yonaguska/SMD_test_rig_with_Pico/Photos/2026-06-17_19-35-20_testing.png

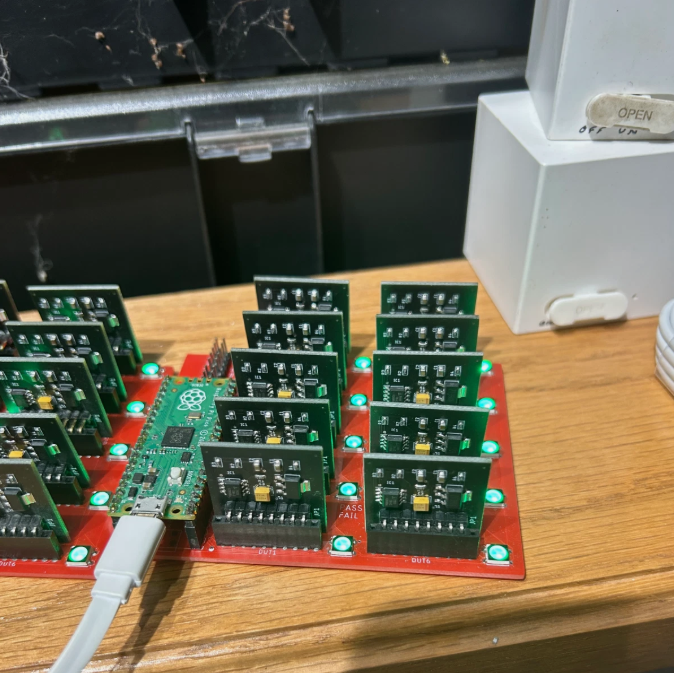
Photos/2026-06-17_19-35-20_testing.png
