yonaguska/SMD_test_rig_with_Pico/README.md

# SMD_test_rig_with_Pico
This is an automated test system for the SMD watchdog timers.
