yonaguska/SMD_test_rig_with_Pico/Photos/image0.jpeg

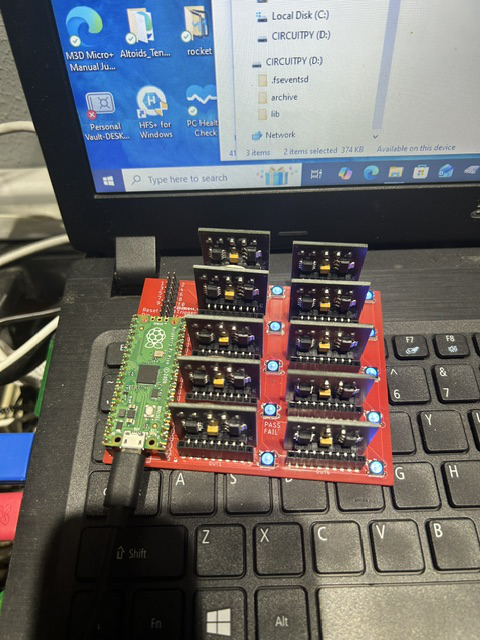
Photos/image0.jpeg
