yonaguska/SMD_test_rig_with_Pico/Photos/image1.jpeg

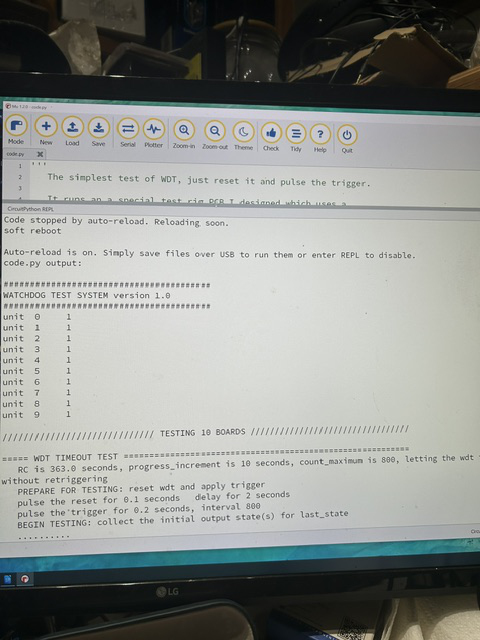
Photos/image1.jpeg
