yonaguska/SMD_test_rig_with_Pico/Photos/IMG_9965.jpeg

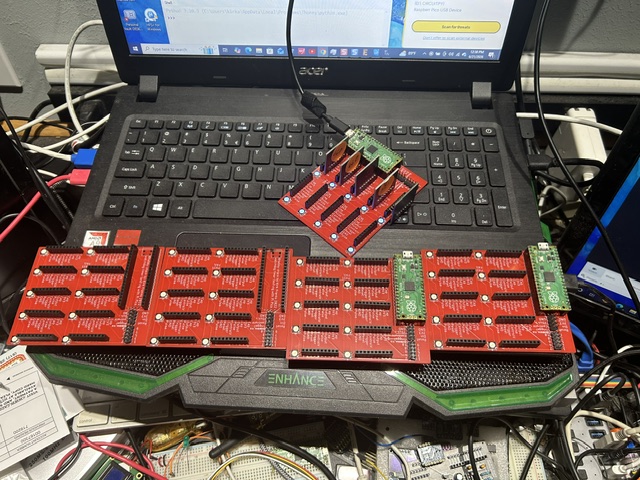
Photos/IMG_9965.jpeg
