yonaguska/SMD_test_rig_with_Pico/Eagle/smd_test_rig_with_pico.brd

## EAGLE design Eagle/smd_test_rig_with_pico.brd (2026-06-21)

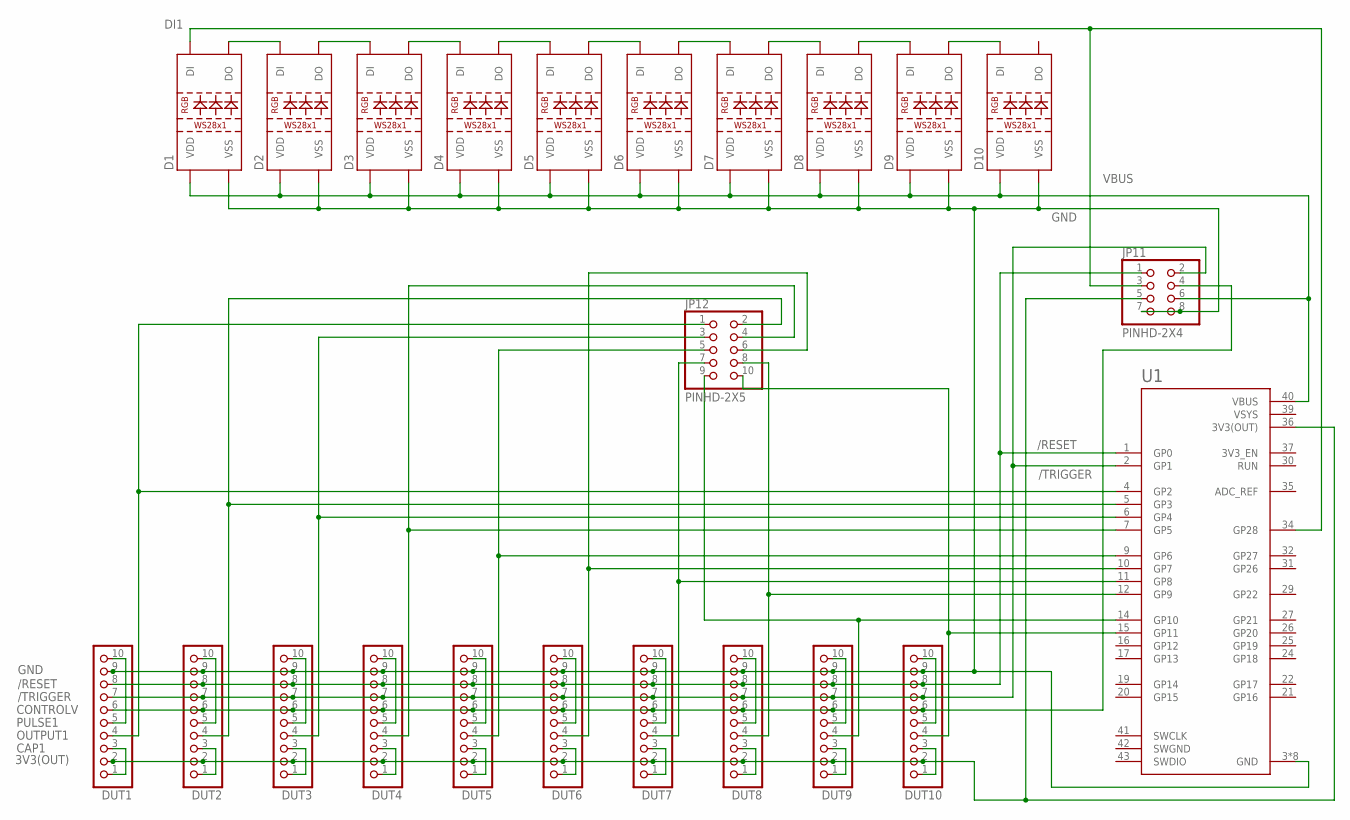
[picture p6: schematic smd_test_rig_with_pico.sch]

Parts:
D1, D2, D3, D4, D5, D6, D7, D8, D9, D10: WS2812B
DUT1, DUT2, DUT3, DUT4, DUT5, DUT6, DUT7, DUT8, DUT9, DUT10: PINHD-1X10; 1X10
JP11: PINHD-2X4; 2X04
JP12: PINHD-2X5; 2X05
U1: RASPBERRY_PICO; PICO-PKG-TH

Connections:
3V3(OUT): DUT1.2, DUT2.2, DUT3.2, DUT4.2, DUT5.2, DUT6.2, DUT7.2, DUT8.2, DUT9.2, DUT10.2, JP11.5, U1.36 (3V3(OUT))
/RESET: DUT1.8, DUT2.8, DUT3.8, DUT4.8, DUT5.8, DUT6.8, DUT7.8, DUT8.8, DUT9.8, DUT10.8, JP11.1, U1.1 (GP0)
/TRIGGER: DUT1.7, DUT2.7, DUT3.7, DUT4.7, DUT5.7, DUT6.7, DUT7.7, DUT8.7, DUT9.7, DUT10.7, JP11.2, U1.2 (GP1)
CAP1: DUT1.1, DUT1.3
CAP2: DUT2.1, DUT2.3
CAP3: DUT3.1, DUT3.3
CAP4: DUT4.1, DUT4.3
CAP5: DUT5.1, DUT5.3
CAP6: DUT6.1, DUT6.3
CAP7: DUT7.1, DUT7.3
CAP8: DUT8.1, DUT8.3
CAP9: DUT9.1, DUT9.3
CAP10: DUT10.1, DUT10.3
CONTROLV: DUT1.6, DUT2.6, DUT3.6, DUT4.6, DUT5.6, DUT6.6, DUT7.6, DUT8.6, DUT9.6, DUT10.6, JP11.4
DI1: D1.4 (DI), JP11.3, U1.34 (GP28)
GND: D1.3 (VSS), D2.3 (VSS), D3.3 (VSS), D4.3 (VSS), D5.3 (VSS), D6.3 (VSS), D7.3 (VSS), D8.3 (VSS), D9.3 (VSS), D10.3 (VSS), DUT1.9, DUT2.9, DUT3.9, DUT4.9, DUT5.9, DUT6.9, DUT7.9, DUT8.9, DUT9.9, DUT10.9, JP11.7, JP11.8, U1.3 (GND), U1.8 (GND), U1.13 (GND), U1.18 (GND), U1.23 (GND), U1.28 (GND), U1.33 (GND), U1.38 (GND)
unnamed: D1.2 (DO), D2.4 (DI)
unnamed: D2.2 (DO), D3.4 (DI)
unnamed: D3.2 (DO), D4.4 (DI)
unnamed: D4.2 (DO), D5.4 (DI)
unnamed: D5.2 (DO), D6.4 (DI)
unnamed: D6.2 (DO), D7.4 (DI)
unnamed: D7.2 (DO), D8.4 (DI)
unnamed: D8.2 (DO), D9.4 (DI)
unnamed: D9.2 (DO), D10.4 (DI)
OUTPUT1: DUT1.4, JP12.1, U1.4 (GP2)
OUTPUT2: DUT2.4, JP12.2, U1.5 (GP3)
OUTPUT3: DUT3.4, JP12.3, U1.6 (GP4)
OUTPUT4: DUT4.4, JP12.4, U1.7 (GP5)
OUTPUT5: DUT5.4, JP12.5, U1.9 (GP6)
OUTPUT6: DUT6.4, JP12.6, U1.10 (GP7)
OUTPUT7: DUT7.4, JP12.7, U1.11 (GP8)
OUTPUT8: DUT8.4, JP12.8, U1.12 (GP9)
OUTPUT9: DUT9.4, JP12.9, U1.14 (GP10)
OUTPUT10: DUT10.4, JP12.10, U1.15 (GP11)
PULSE1: DUT1.5, DUT1.10
PULSE2: DUT2.5, DUT2.10
PULSE3: DUT3.5, DUT3.10
PULSE4: DUT4.5, DUT4.10
PULSE5: DUT5.5, DUT5.10
PULSE6: DUT6.5, DUT6.10
PULSE7: DUT7.5, DUT7.10
PULSE8: DUT8.5, DUT8.10
PULSE9: DUT9.5, DUT9.10
PULSE10: DUT10.5, DUT10.10
SWGND: U1.42 (SWGND)
VBUS: D1.1 (VDD), D2.1 (VDD), D3.1 (VDD), D4.1 (VDD), D5.1 (VDD), D6.1 (VDD), D7.1 (VDD), D8.1 (VDD), D9.1 (VDD), D10.1 (VDD), JP11.6, U1.40 (VBUS)
VSYS: U1.39 (VSYS)

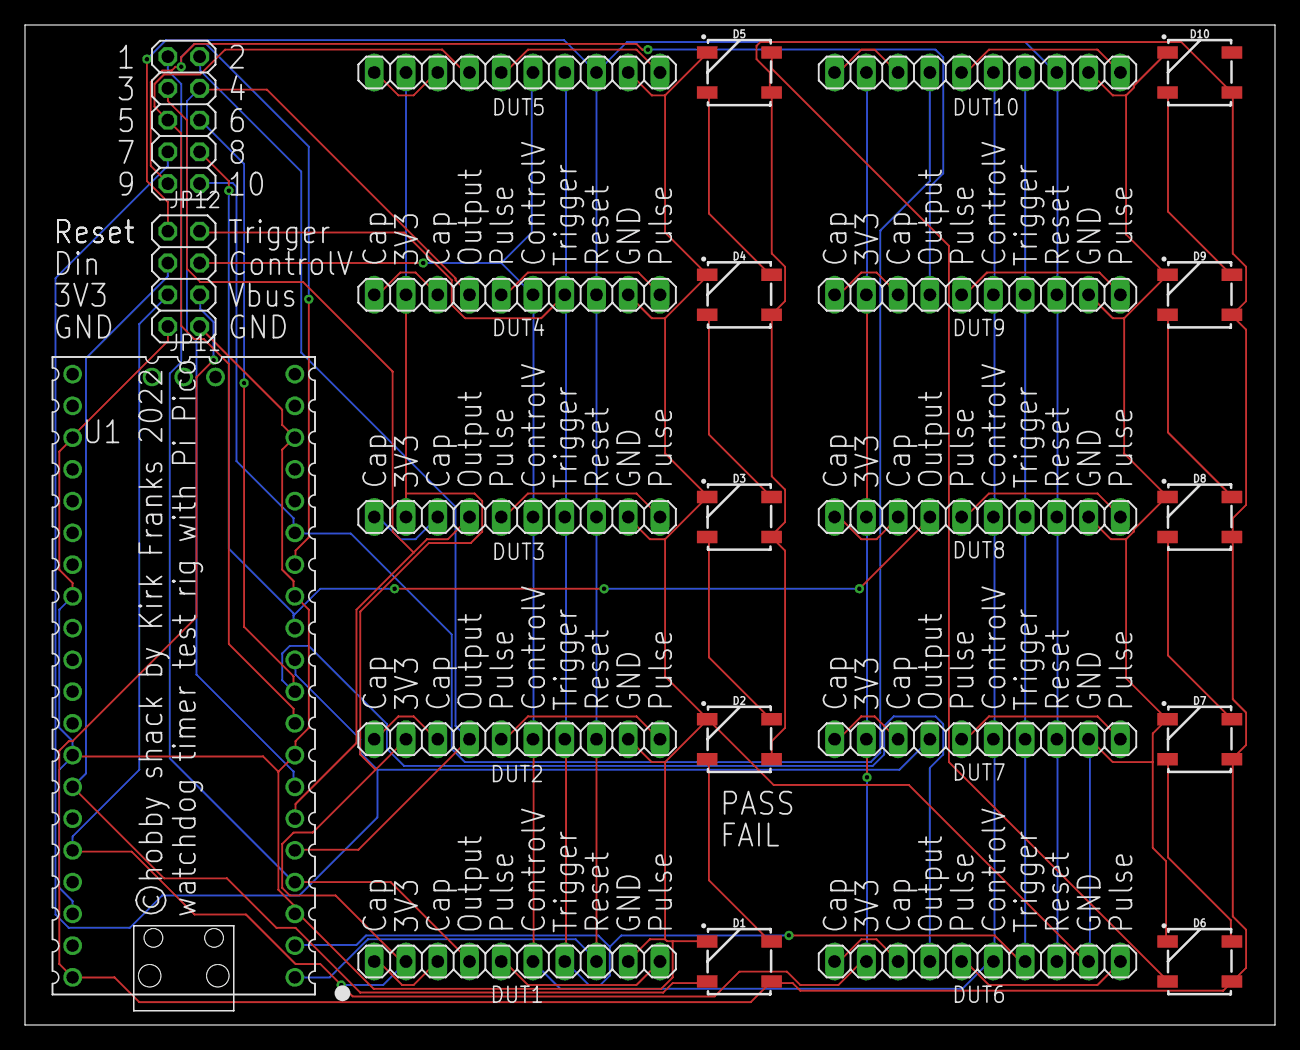
[picture p7: board smd_test_rig_with_pico.brd from above]

Board: 2 copper layers, 100.0 x 80.0 mm, 23 parts (0 on the bottom side), 46 nets.
