yonaguska/SMD_test_rig_with_Pico/Eagle/smd_test_rig_with_pico_board.png

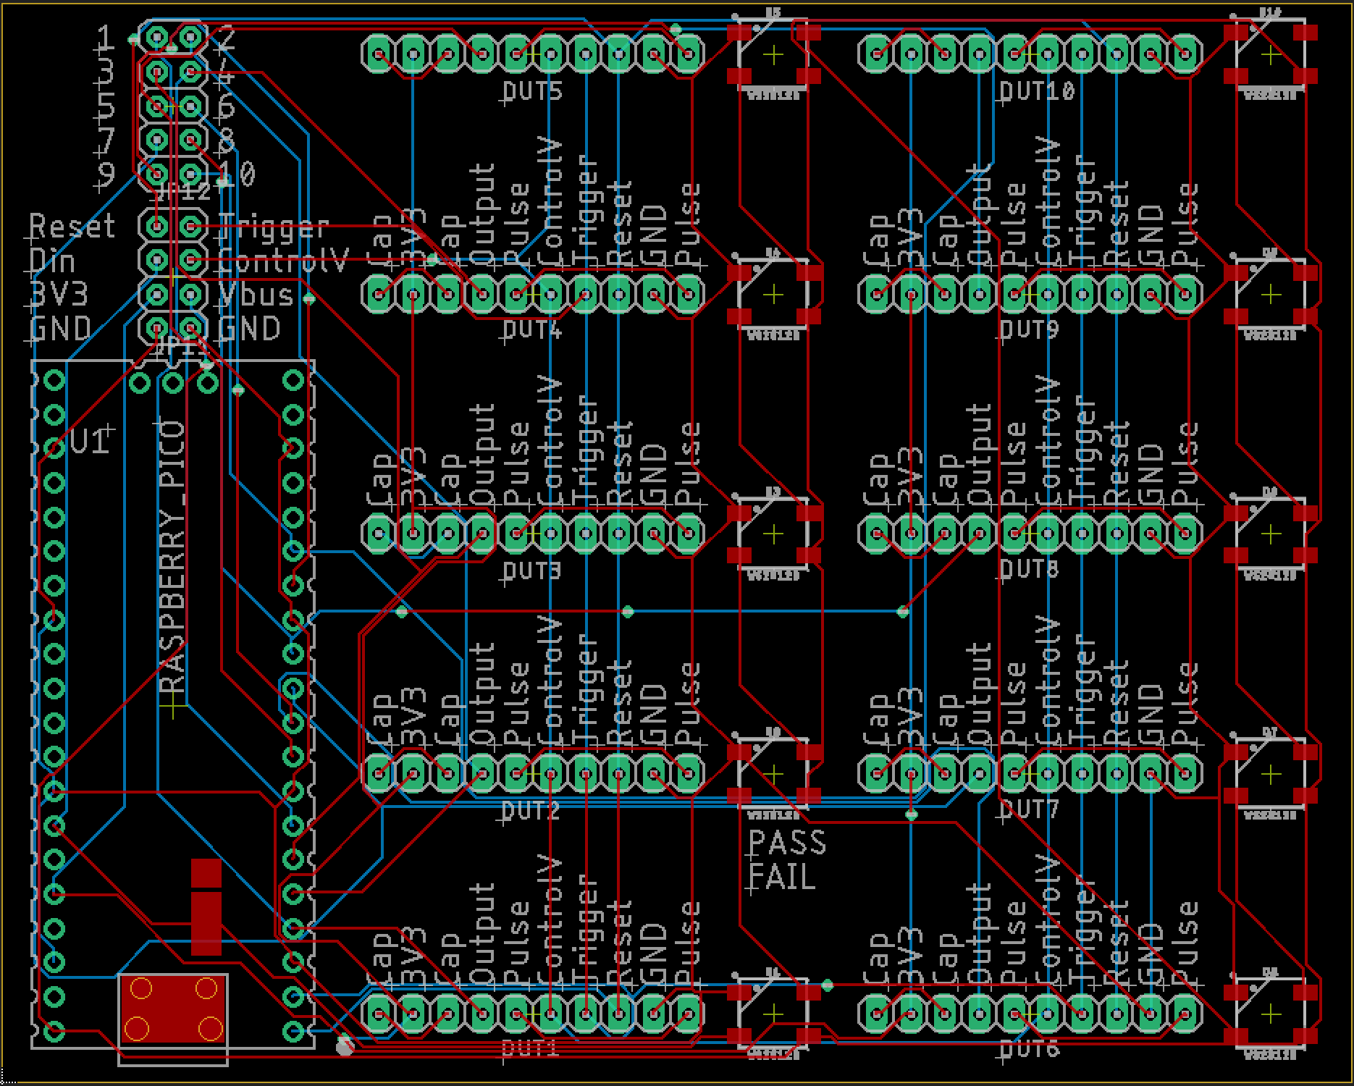
Eagle/smd_test_rig_with_pico_board.png
