yonaguska/SMD_test_rig_with_Pico/Eagle/smd_test_rig_with_pico_schematic.png

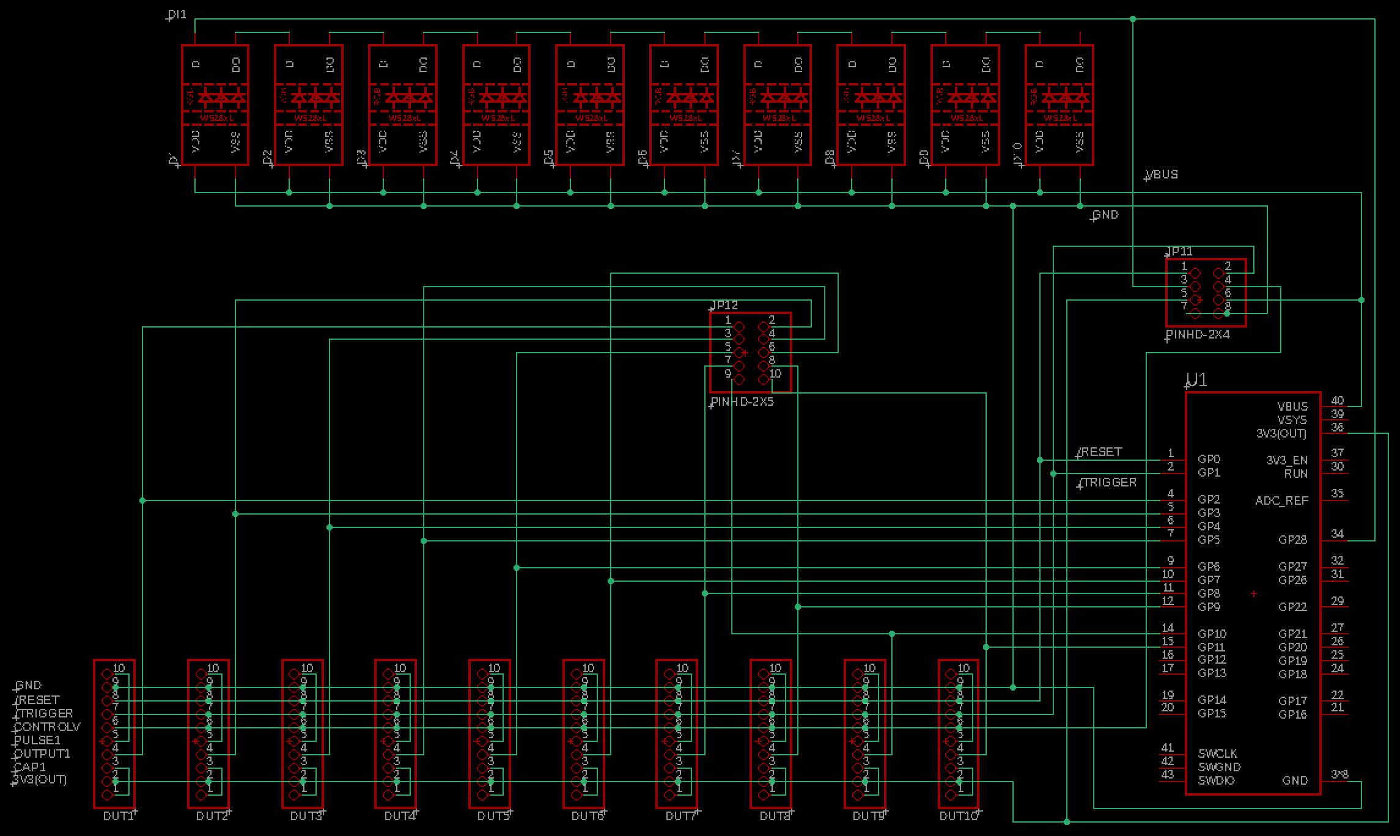
Eagle/smd_test_rig_with_pico_schematic.png
