yonaguska/SMD_test_rig_with_Pico/(notices)

Notices in the files:
Eagle/smd_test_rig_with_pico.brd:
©hobby shack by Kirk Franks 2022
parts and their libraries:
SparkFun-LED: Licensing: Creative Commons ShareAlike 4.0 International - https://creativecommons.org/licenses/by-sa/4.0
